Plourde-Research-Lab/JPM-SFQ/Figures/Figures.pptx

## ASC Paper Figures

## Basic Idea

Qubit/Cavity

1

0

M

JTL

JPM

## Circuit Diagram

Reset

DC-SFQ

Merger

5-cell ballistic JTL

5-cell ballistic JTL

JTL

JPM

M

I_(bias)

Trigger

DC-SFQ

Splitter

DFF

SFQ-DC

Out

Merger

5-cell ballistic JTL

-M

5-cell ballistic JTL

JTL

JTL
