Plourde-Research-Lab/JPM-SFQ/Figures/delay.pdf

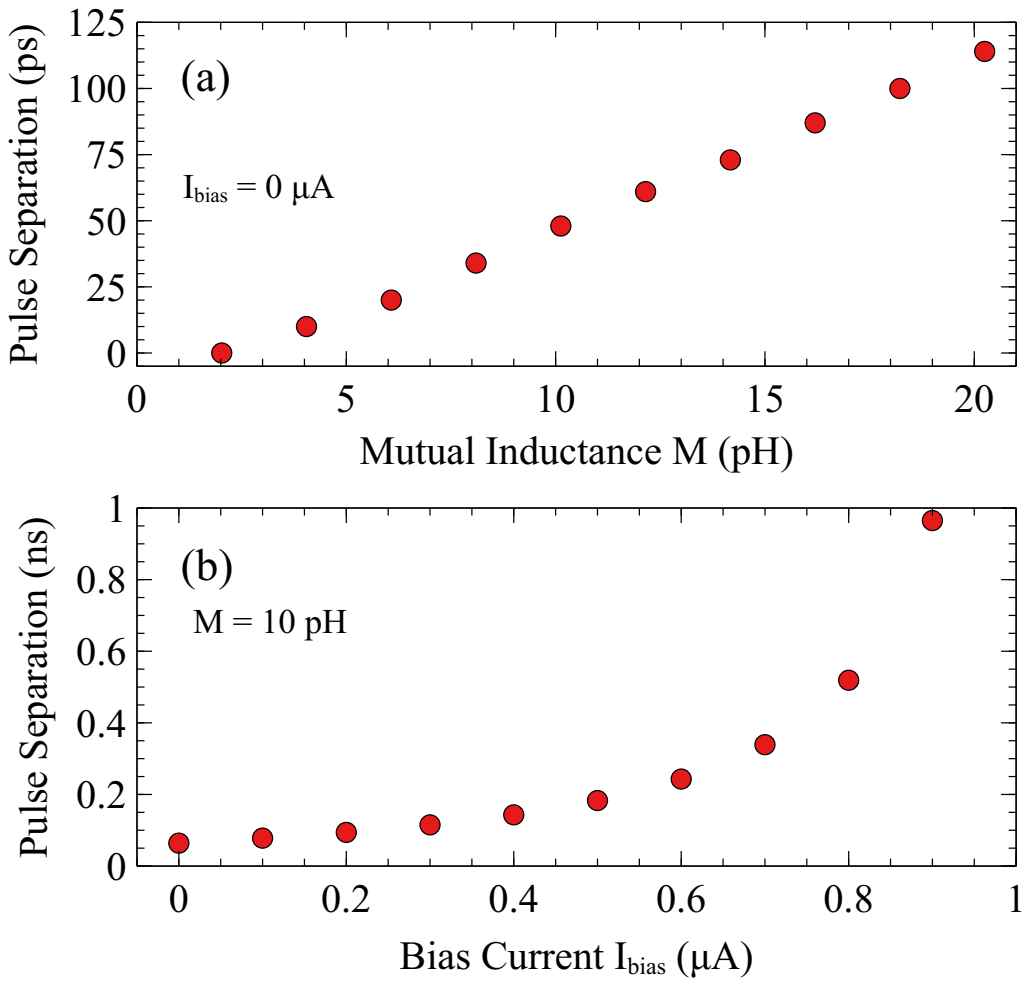
[picture p1: figure]
(a) Ibias =; Pulse Separation (ps); utual In; ductance M (p; Pulse Separation (ns); Bias C; urrent Ibias (μ
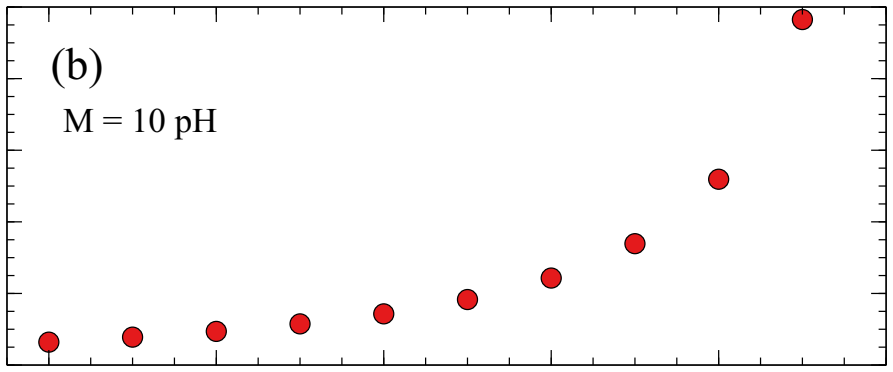
[picture p2: figure]
