Plourde-Research-Lab/JPM-SFQ/layout/extractions/ex1/ex1_circuit-schematic.pdf

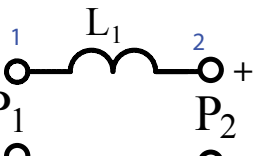
[picture p8: figure]

P

+
