Plourde-Research-Lab/JPM-SFQ/Comparator Readout/Comparator/Picture1.pdf

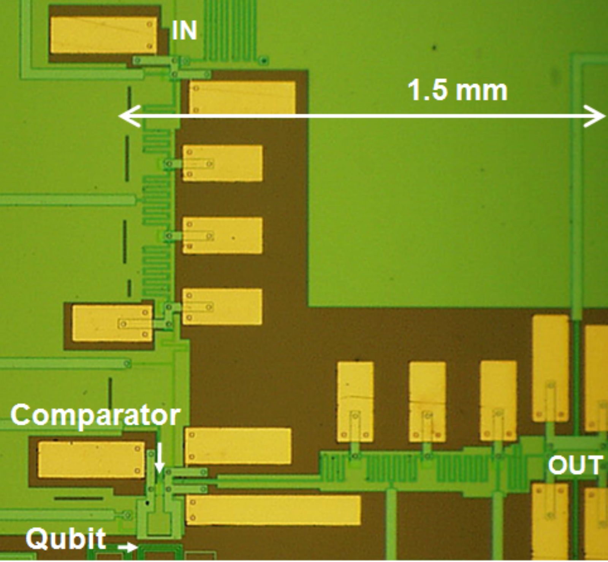
[picture p9: page 1]
