Plourde-Research-Lab/JPM-SFQ/Ballistic Readout/ASC Paper/Reviewer Responses-BP.pdf

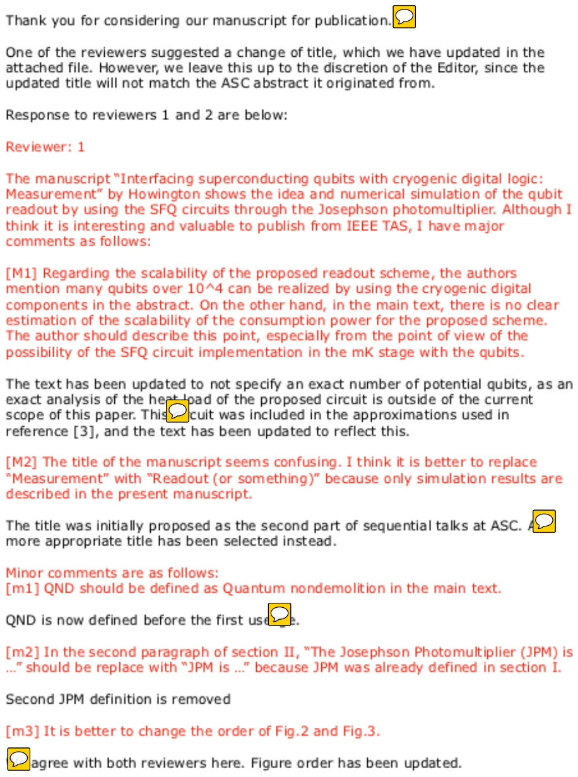
[picture p10: page 1]
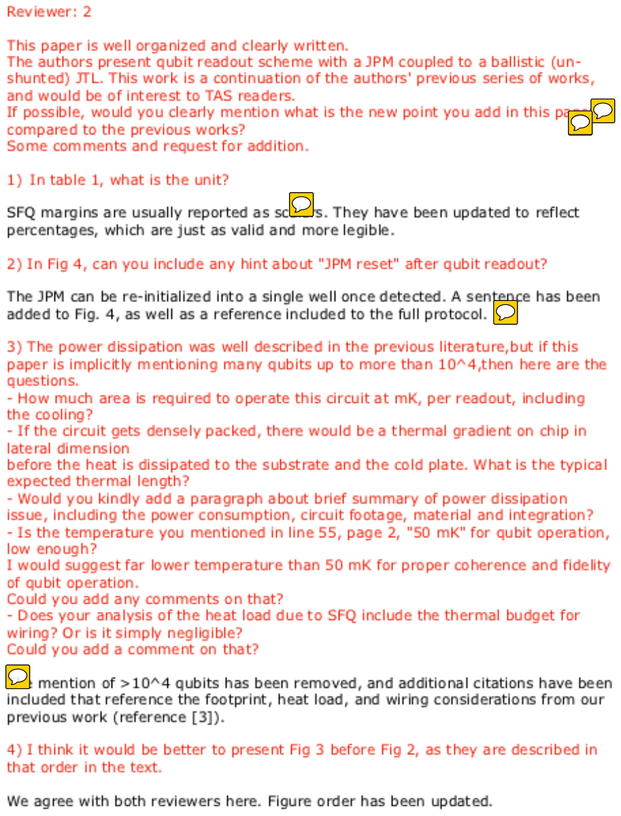
[picture p11: page 2]
