Plourde-Research-Lab/JPM-SFQ/components/rsfq_lib/suny_schematics/ANDschem.jpg

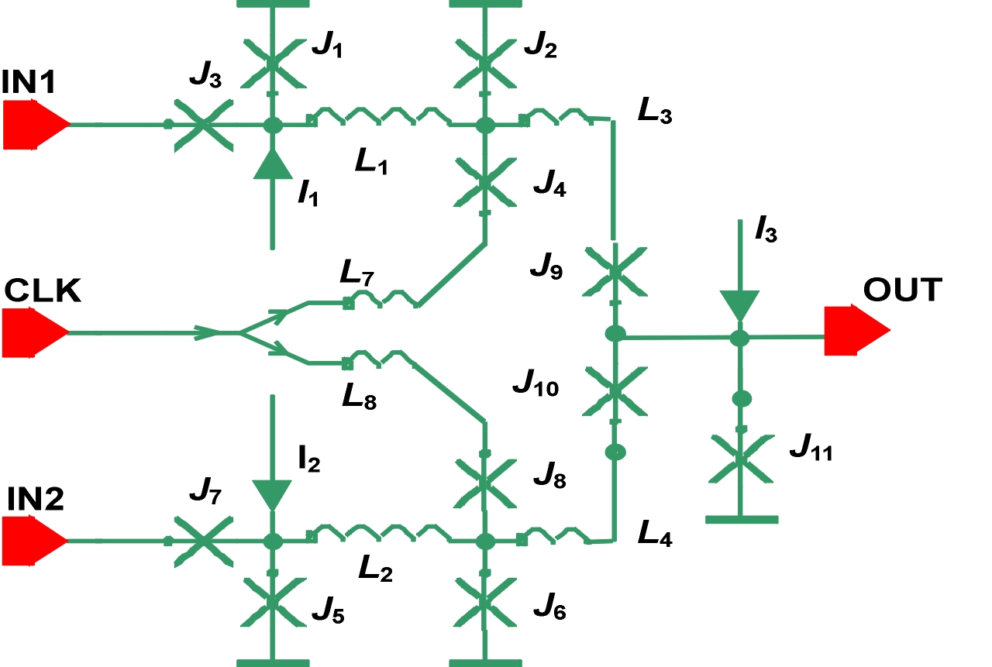
components/rsfq_lib/suny_schematics/ANDschem.jpg
