Plourde-Research-Lab/JPM-SFQ/components/rsfq_lib/suny_schematics/BFFschem.jpg

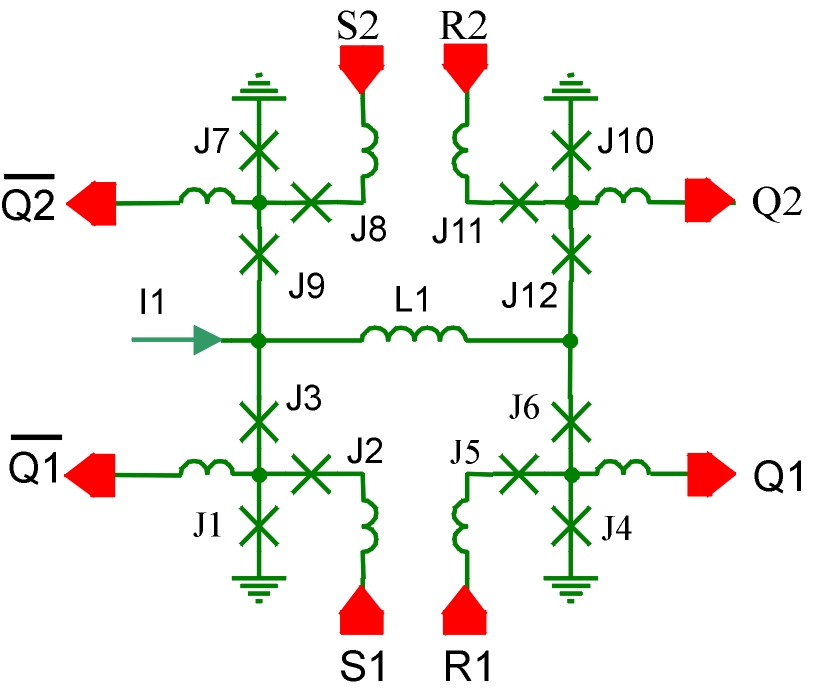
components/rsfq_lib/suny_schematics/BFFschem.jpg
