Plourde-Research-Lab/JPM-SFQ/components/rsfq_lib/suny_schematics/c-not.gif

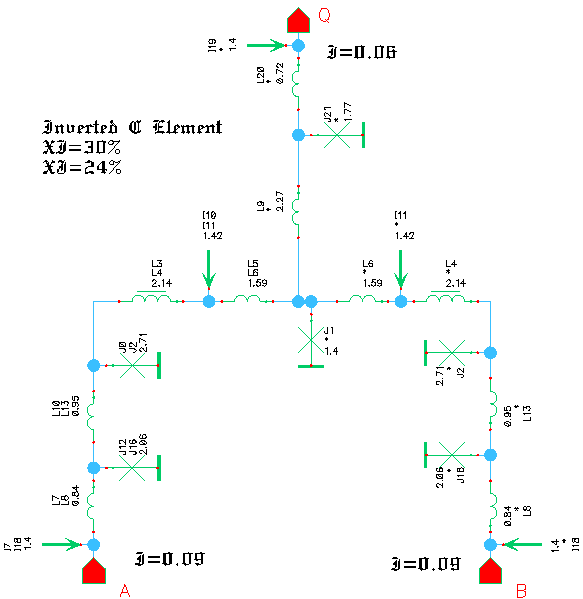
components/rsfq_lib/suny_schematics/c-not.gif
