Plourde-Research-Lab/JPM-SFQ/components/rsfq_lib/suny_schematics/d2.gif

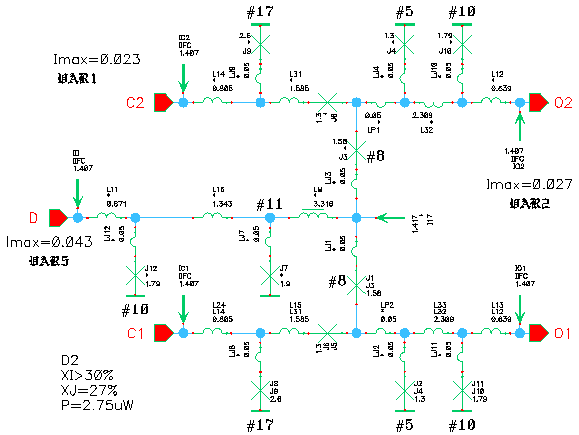
components/rsfq_lib/suny_schematics/d2.gif
