Plourde-Research-Lab/JPM-SFQ/components/rsfq_lib/suny_schematics/dcsfq-schematic.gif

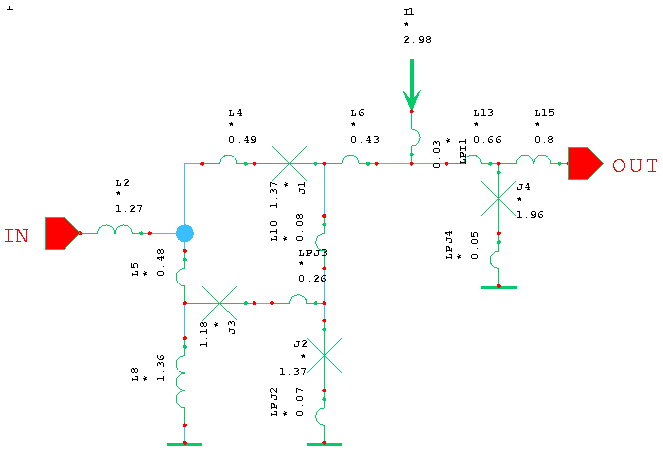
components/rsfq_lib/suny_schematics/dcsfq-schematic.gif
