Plourde-Research-Lab/JPM-SFQ/components/rsfq_lib/suny_schematics/dff-schematic.gif

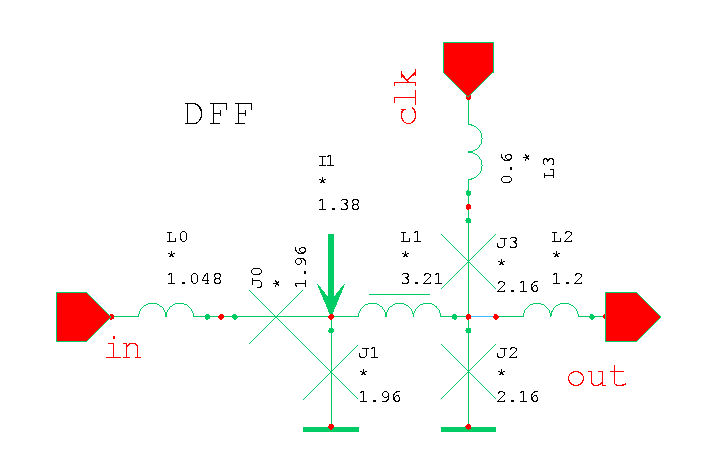
components/rsfq_lib/suny_schematics/dff-schematic.gif
