Plourde-Research-Lab/JPM-SFQ/components/rsfq_lib/suny_schematics/dffc.gif

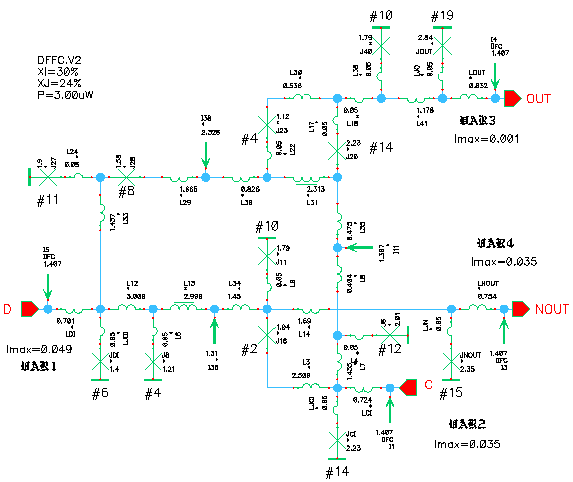
components/rsfq_lib/suny_schematics/dffc.gif
