Plourde-Research-Lab/JPM-SFQ/components/rsfq_lib/suny_schematics/inv.sch.gif

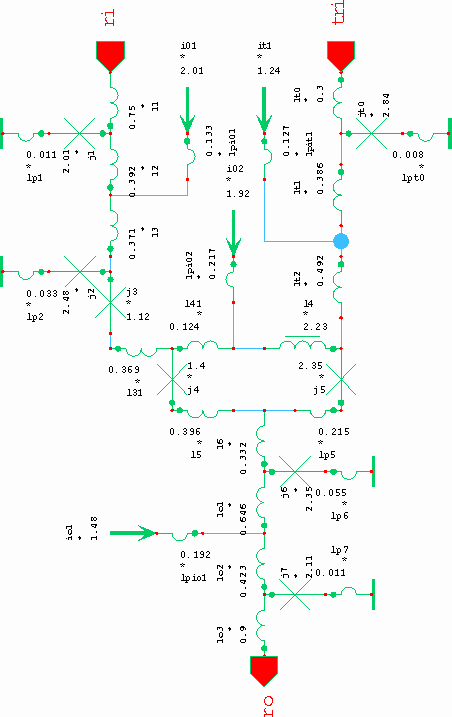
components/rsfq_lib/suny_schematics/inv.sch.gif
