Plourde-Research-Lab/JPM-SFQ/components/rsfq_lib/suny_schematics/jtl.sch.gif

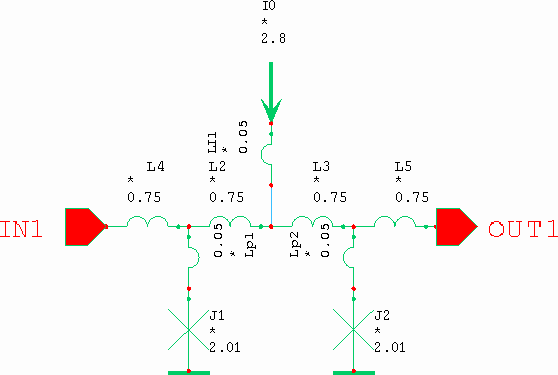
components/rsfq_lib/suny_schematics/jtl.sch.gif
