Plourde-Research-Lab/JPM-SFQ/components/rsfq_lib/suny_schematics/merge.sch.gif

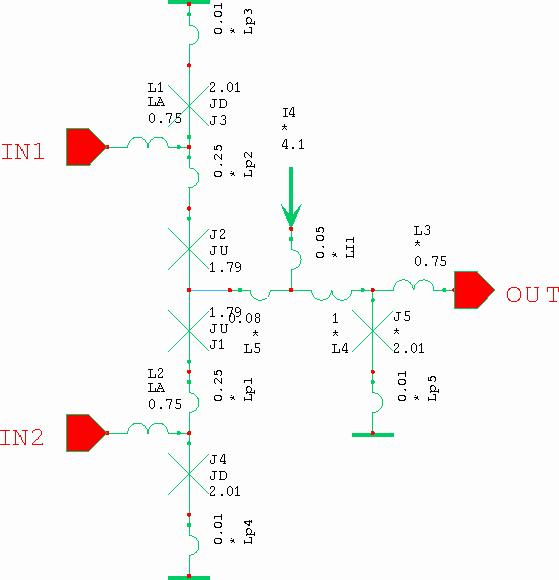
components/rsfq_lib/suny_schematics/merge.sch.gif
