Plourde-Research-Lab/JPM-SFQ/components/rsfq_lib/suny_schematics/msdrv.sch.gif

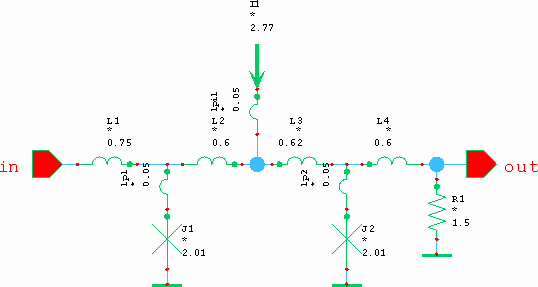
components/rsfq_lib/suny_schematics/msdrv.sch.gif
