Plourde-Research-Lab/JPM-SFQ/components/rsfq_lib/suny_schematics/msrec.sch.gif

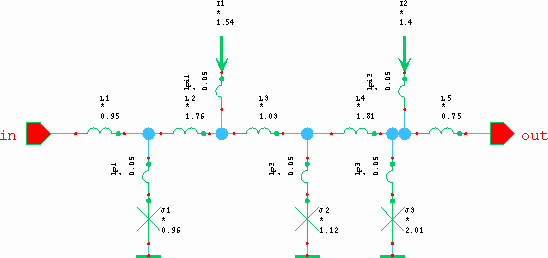
components/rsfq_lib/suny_schematics/msrec.sch.gif
