Plourde-Research-Lab/JPM-SFQ/components/rsfq_lib/suny_schematics/ndro-schematic.gif

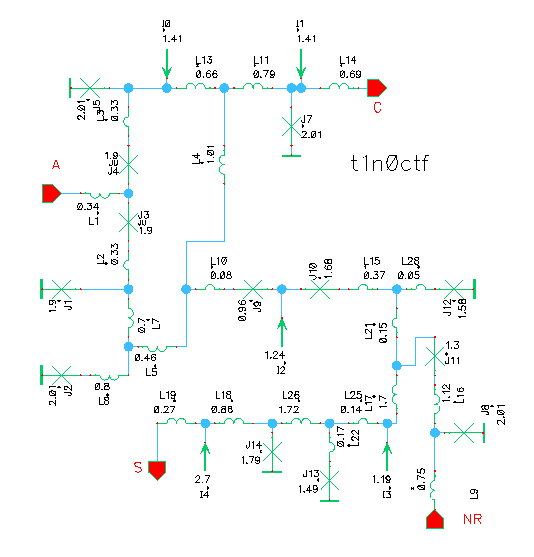
components/rsfq_lib/suny_schematics/ndro-schematic.gif
