Plourde-Research-Lab/JPM-SFQ/components/rsfq_lib/suny_schematics/ORschem.jpg

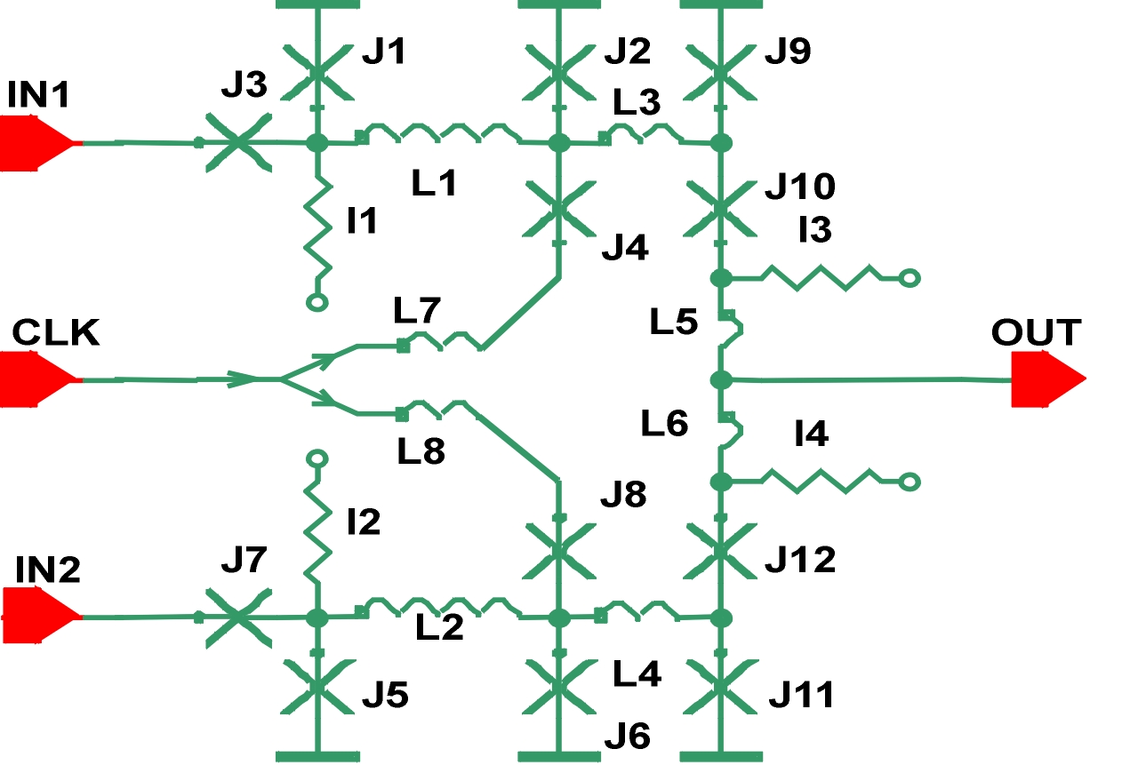
components/rsfq_lib/suny_schematics/ORschem.jpg
