Plourde-Research-Lab/JPM-SFQ/components/rsfq_lib/suny_schematics/sfqdc-schematic.gif

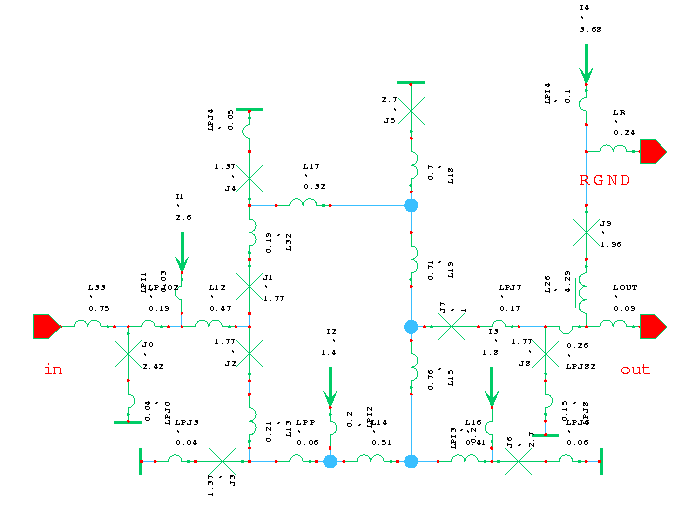
components/rsfq_lib/suny_schematics/sfqdc-schematic.gif
