Plourde-Research-Lab/JPM-SFQ/components/rsfq_lib/suny_schematics/split.sch.gif

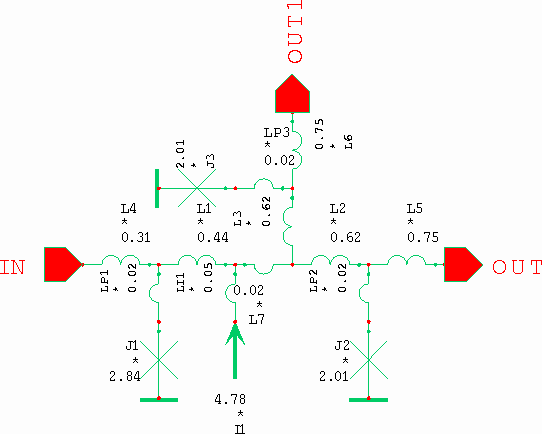
components/rsfq_lib/suny_schematics/split.sch.gif
