Plourde-Research-Lab/JPM-SFQ/components/rsfq_lib/suny_schematics/T1.schematics.gif

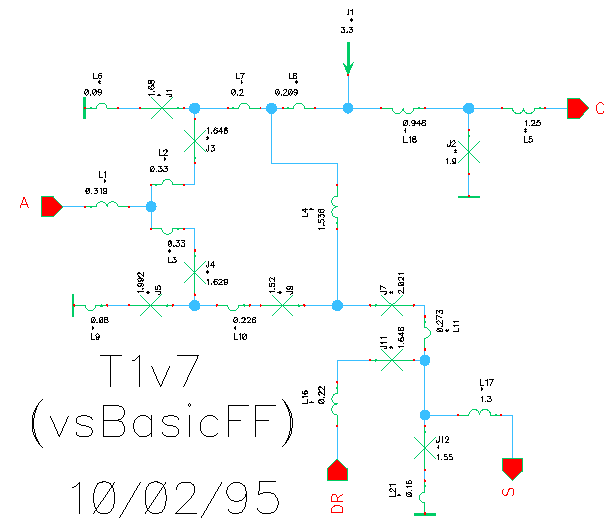
components/rsfq_lib/suny_schematics/T1.schematics.gif
