Plourde-Research-Lab/JPM-SFQ/components/rsfq_lib/suny_schematics/tbi2-sch.gif

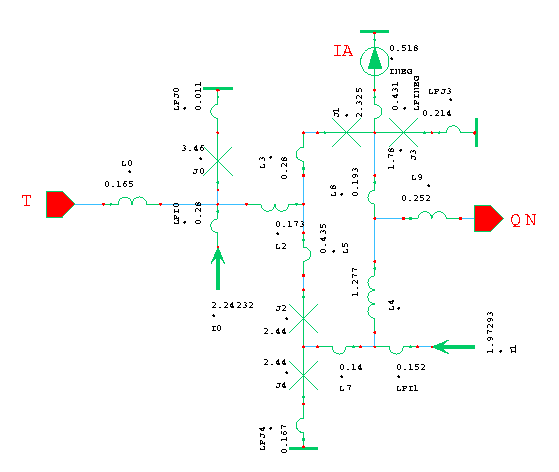
components/rsfq_lib/suny_schematics/tbi2-sch.gif
