Plourde-Research-Lab/JPM-SFQ/components/rsfq_lib/suny_schematics/xor-schematic.gif

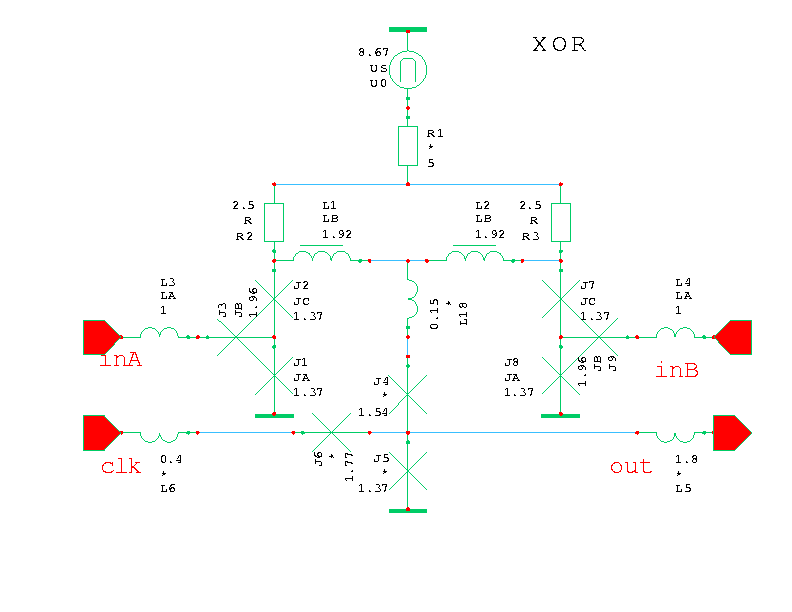
components/rsfq_lib/suny_schematics/xor-schematic.gif
