Plourde-Research-Lab/JPM-SFQ/layout/ComparatorLayout.png

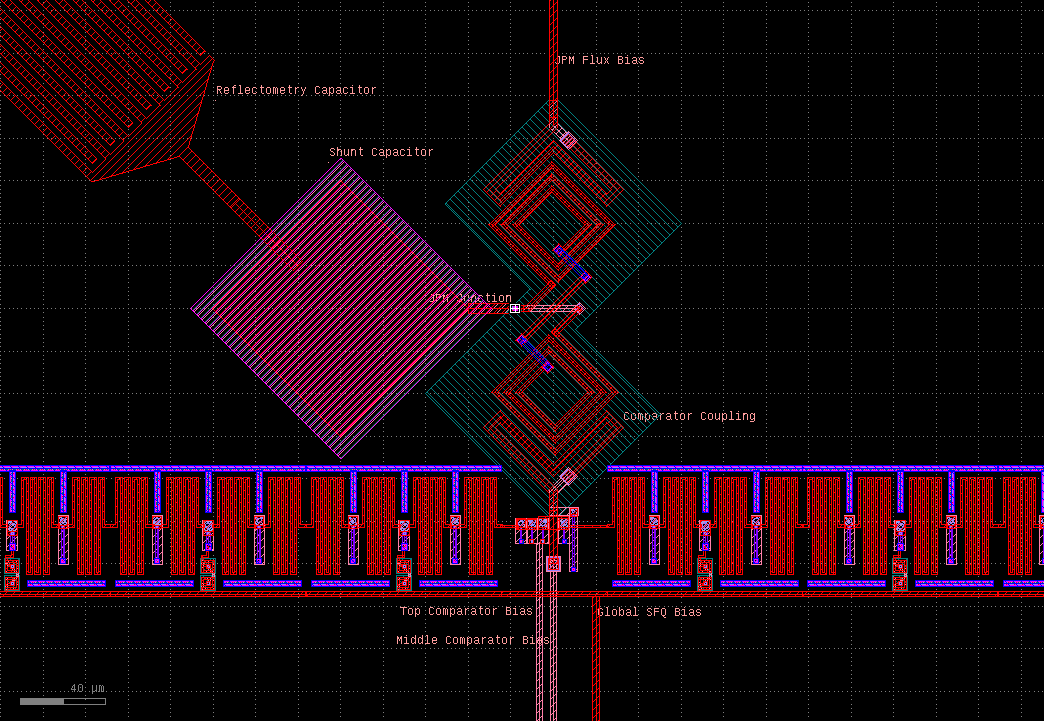
layout/ComparatorLayout.png
