Plourde-Research-Lab/JPM-SFQ/components/dc-sfq-dc/dc-sfq-dc.png

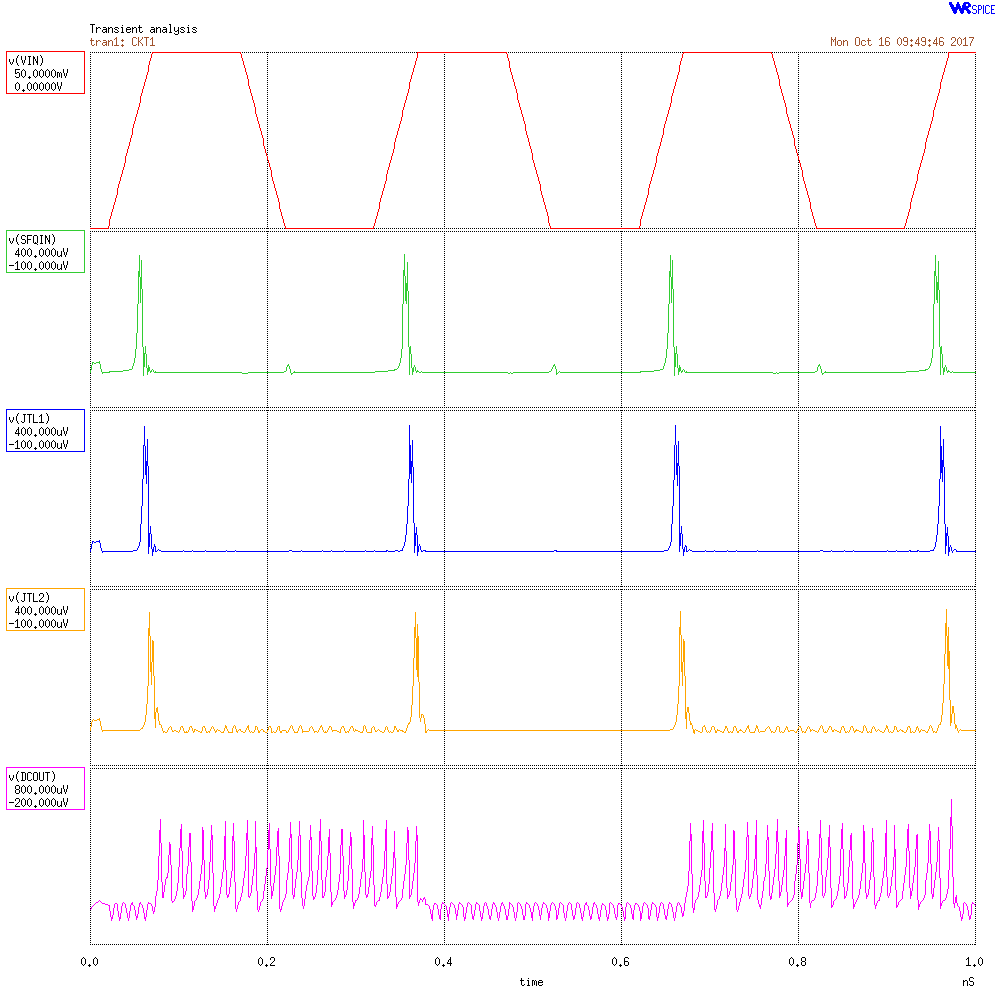
components/dc-sfq-dc/dc-sfq-dc.png
