Plourde-Research-Lab/JPM-SFQ/components/rsfq_lib/dff_schem.png

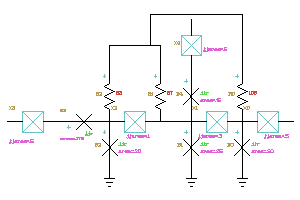
components/rsfq_lib/dff_schem.png
