Plourde-Research-Lab/JPM-SFQ/components/rsfq_lib/prbs_schem.png

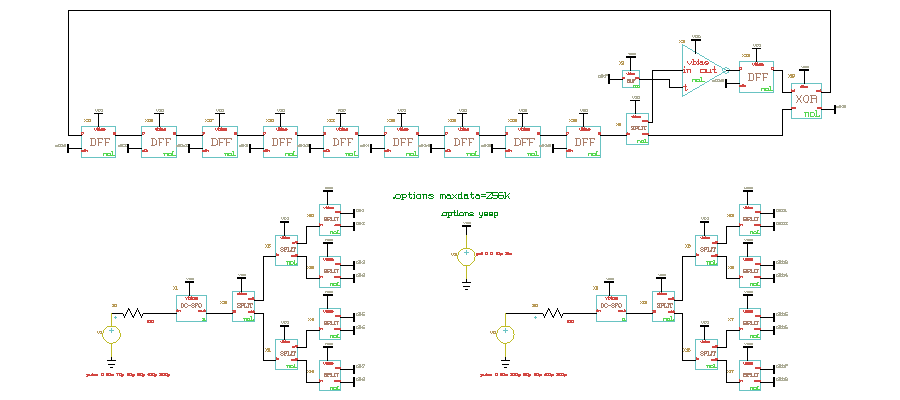
components/rsfq_lib/prbs_schem.png
