Plourde-Research-Lab/JPM-SFQ/components/rsfq_lib/prbs_sim.png

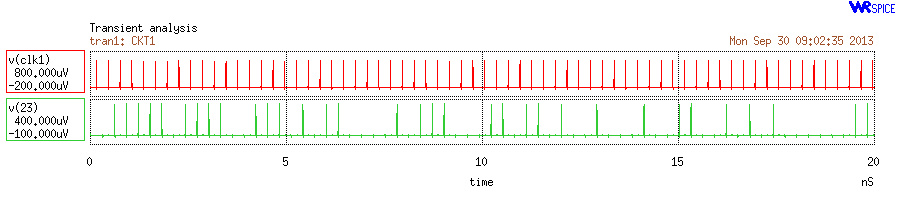
components/rsfq_lib/prbs_sim.png
