Plourde-Research-Lab/JPM-SFQ/components/SU-UWM-Driver/SU-UWM-Driver.png

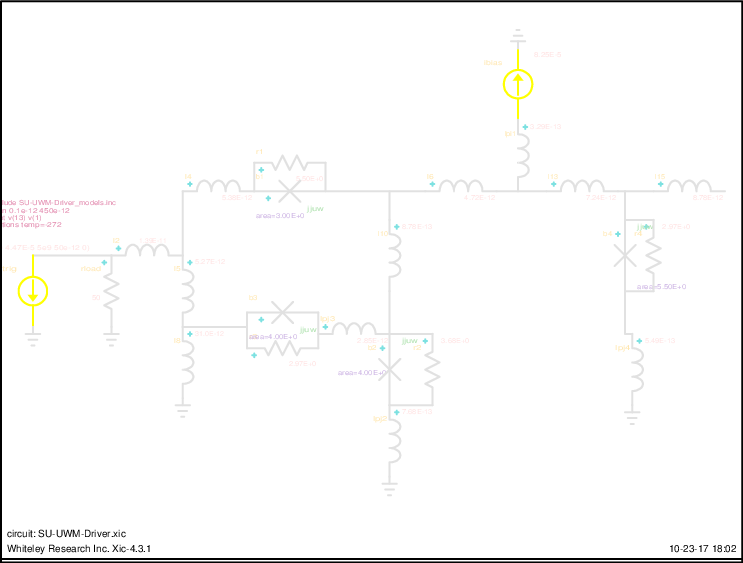
components/SU-UWM-Driver/SU-UWM-Driver.png
