Plourde-Research-Lab/JPM-SFQ/(list of files, cad)

Other CAD files:
layout/extractions/ex_m1/split.dxf
