Plourde-Research-Lab/JPM-SFQ/layout/extractions/test/test_a.txt

0.00000000,1.15463630,;
-1.15463630,0.00000000,;
