Plourde-Research-Lab/JPM-SFQ/components/dcsfq/result.png

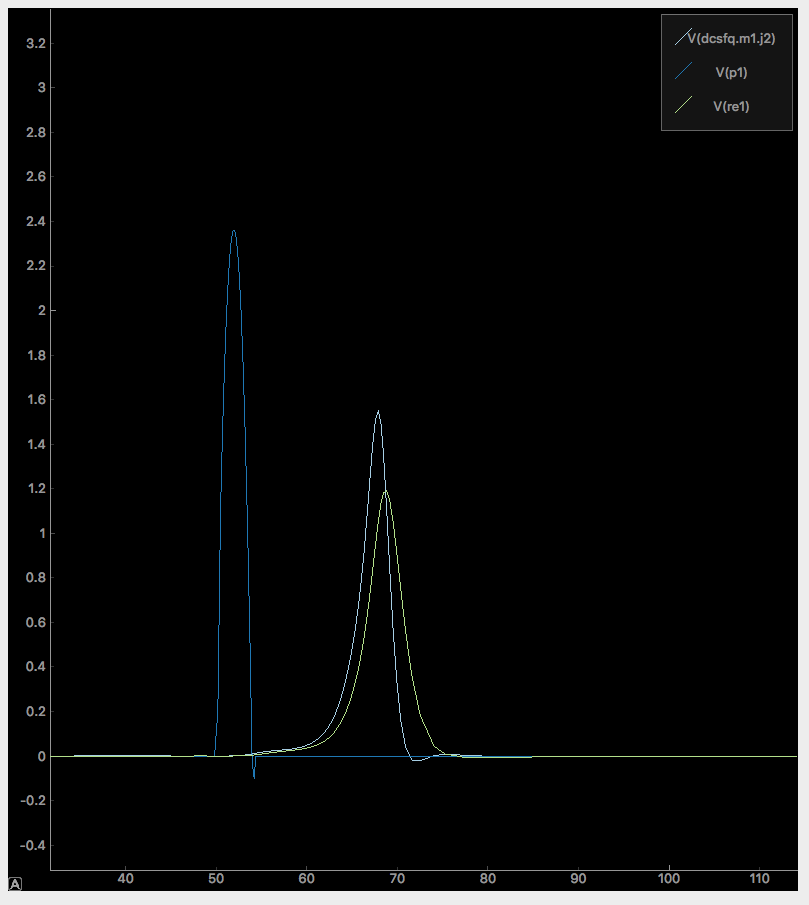
components/dcsfq/result.png
