Plourde-Research-Lab/JPM-SFQ/components/dff/pscan/result.png

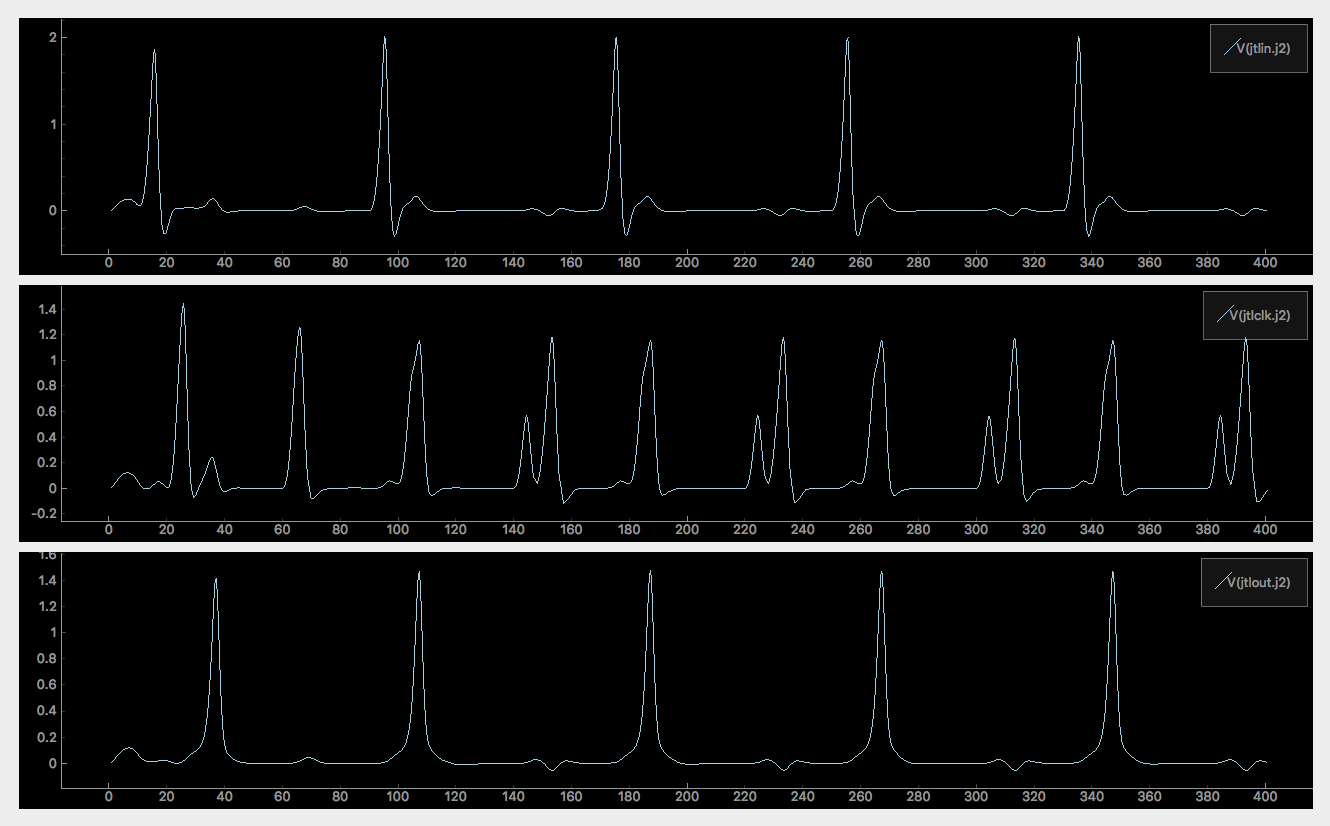
components/dff/pscan/result.png
