Plourde-Research-Lab/JPM-SFQ/components/splitter/result.png

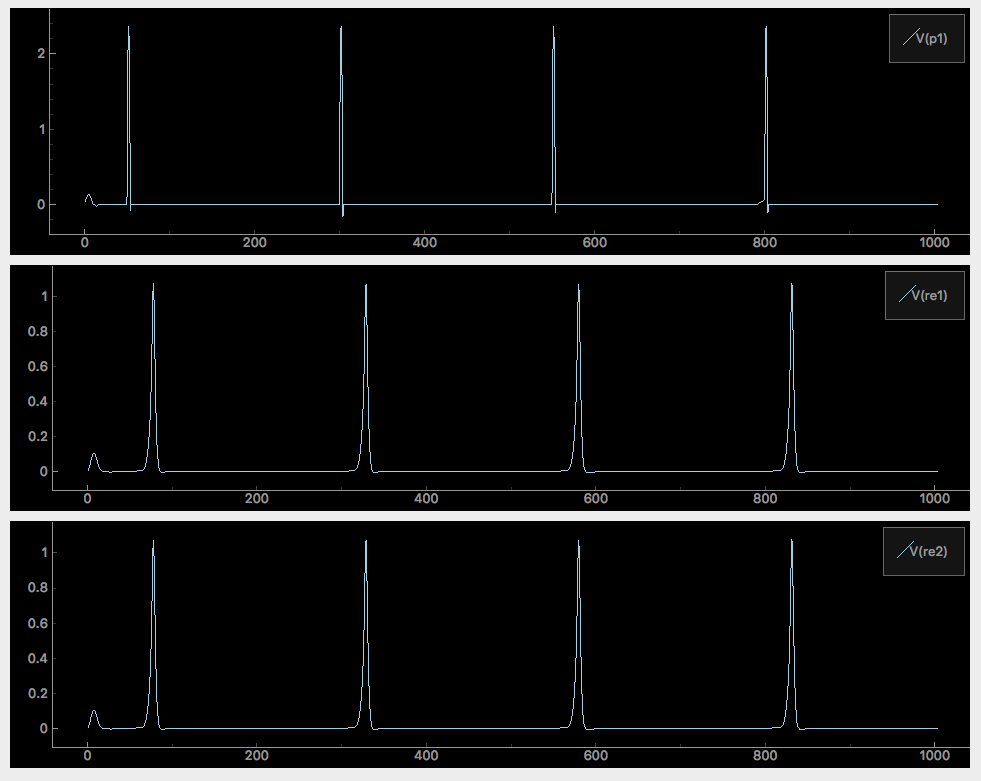
components/splitter/result.png
