Plourde-Research-Lab/JPM-SFQ/components/tff/result.png

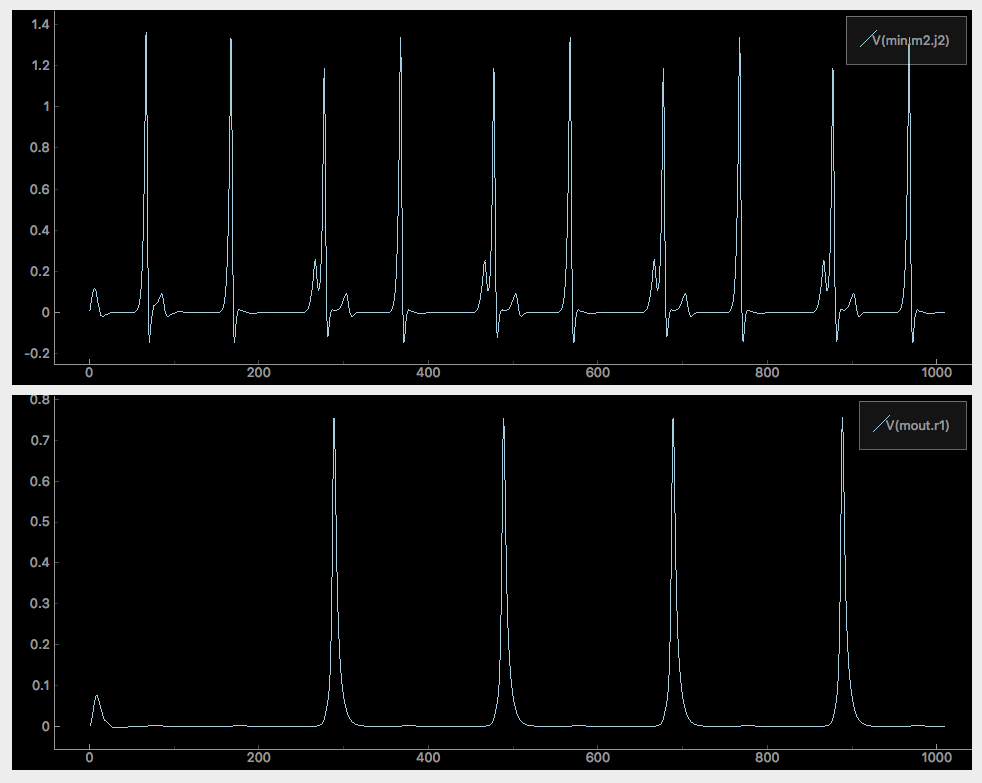
components/tff/result.png
