Plourde-Research-Lab/JPM-SFQ/Figures/Results.png

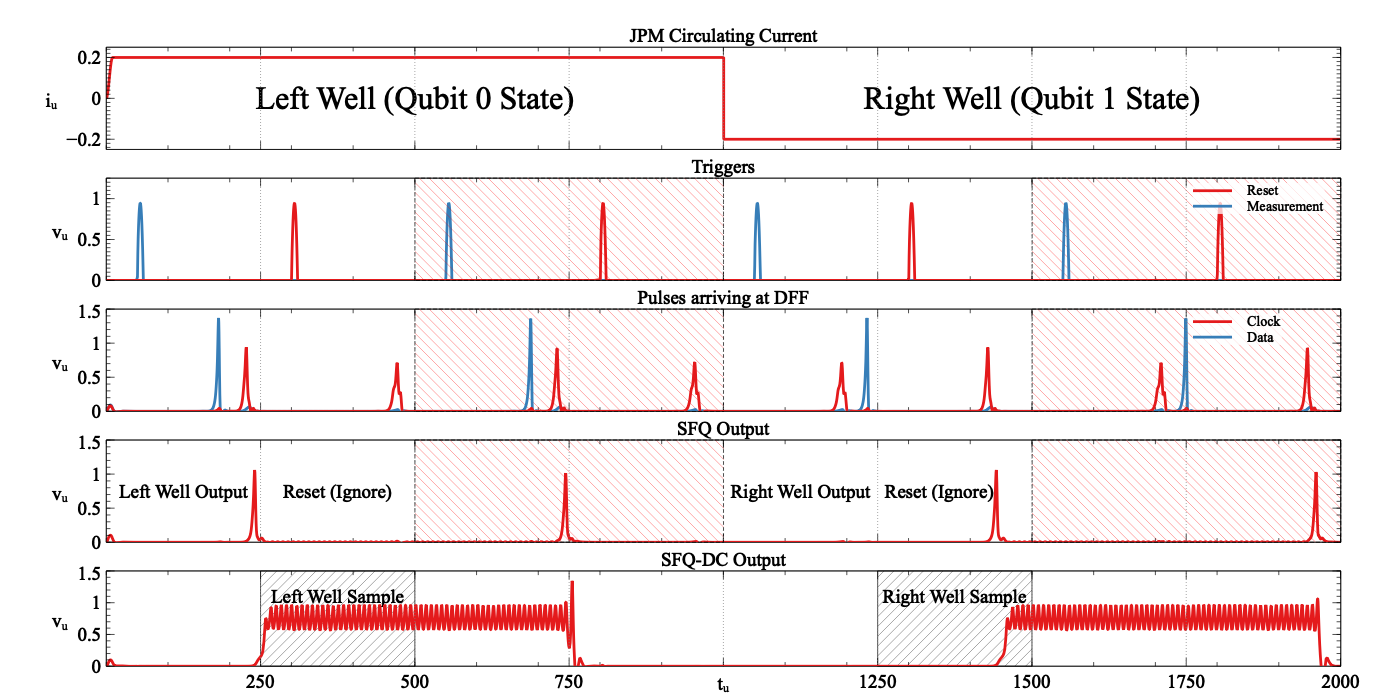
Figures/Results.png
