Plourde-Research-Lab/JPM-SFQ/Figures/Results.pdf

Left Well (Qubit 0 State) | Right Well (Qubit 1 State)

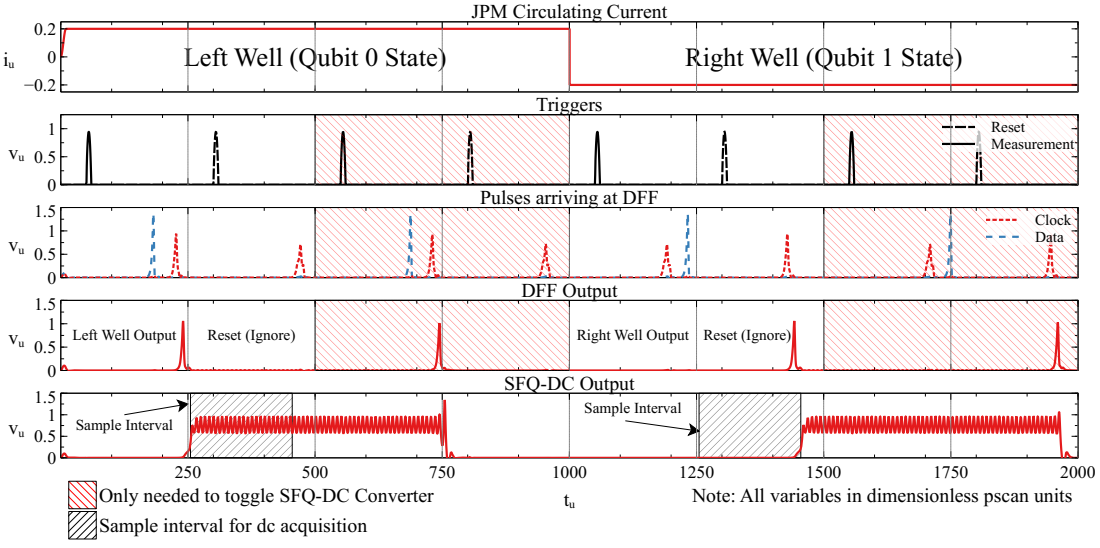
[picture p42: page 1]
Sample interval for dc acquisition; Only needed to toggle SFQ-DC Converter; Triggers; Reset Measurement; Clock Data; Left Well Output; Reset (Ignore); Right Well Output; DFF Output; Sample Interval

JPM Circulating Current

Pulses arriving at DFF

SFQ-DC Output

Note: All variables in dimensionless pscan units
