Plourde-Research-Lab/JPM-SFQ/components/SU-UWM-Driver/SU-UWM-Driver.pdf

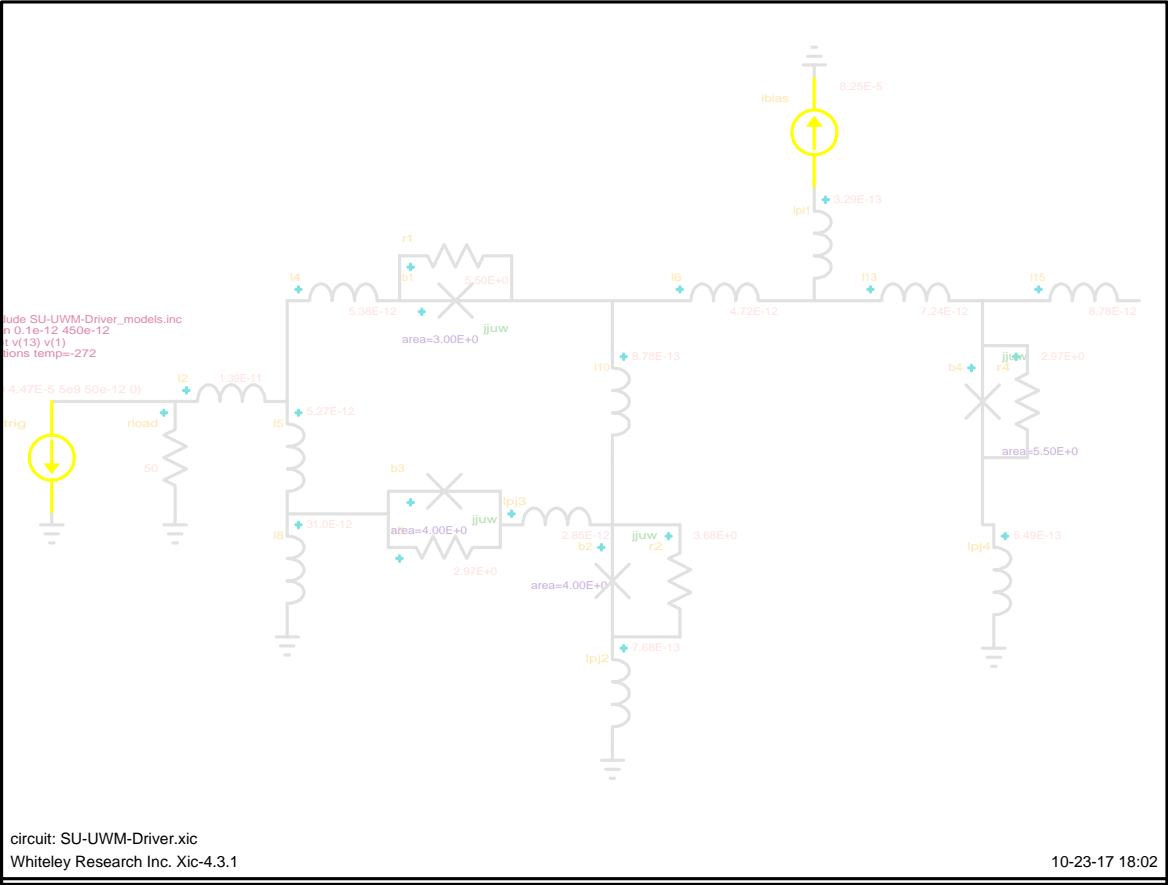
[picture p43: page 1]
ibias; lpi1; itrig; rload; lpj3; lpj4; lpj2; jjuw; area=3.00E+0; area=5.50E+0; area=4.00E+0; Whiteley Research Inc. Xic-4.3.1

clude SU-UWM-Driver_models.inc
ptions temp=-272

circuit: SU-UWM-Driver.xic
