Plourde-Research-Lab/JPM-SFQ/layout/extractions/ex_m1/ex_m1_circuit-schematic.pdf

## 11 PIB + 4

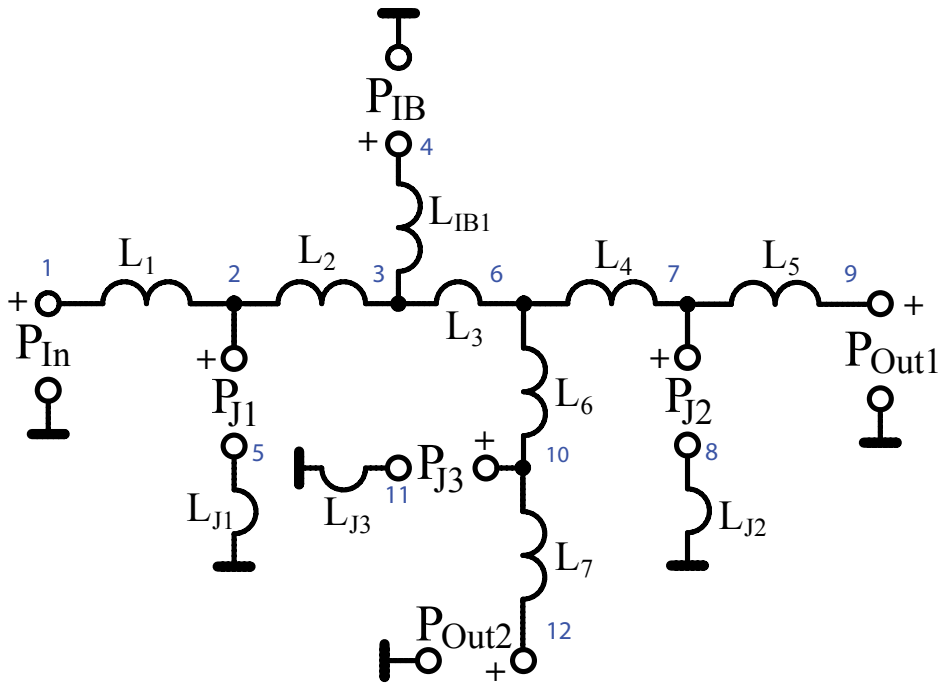
[picture p44: page 1]
PIn +; 9POut1+; POut2; LIB1 L3
