Plourde-Research-Lab/JPM-SFQ/Figures/Comparator Results.pdf

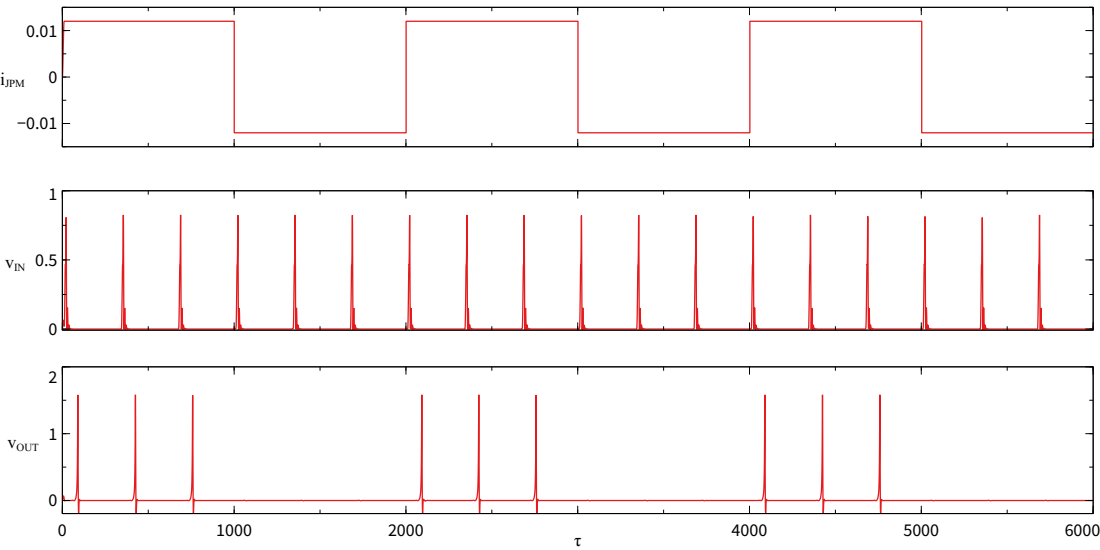
[picture p45: page 1]
iJP; M−0.010 0.01 vIN; 0 0.51 vOUT 012
