Plourde-Research-Lab/JPM-SFQ/components/MutualExample/drv01.pdf

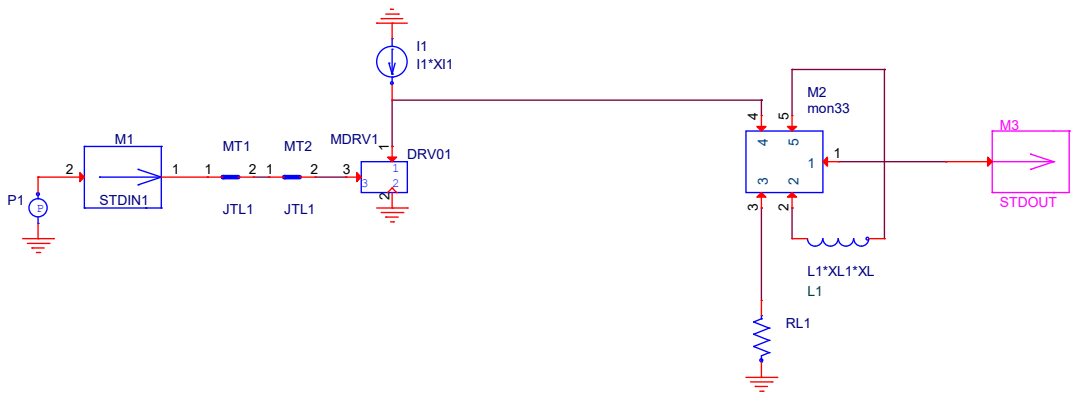
[picture p46: page 1]
Title; Size; Document Number; Rev; Date:; Sheet; <Doc>; <RevCode>; Monday, March 20, 2017; STDOUT; JTL1; M2 mon33; STDIN1; 3 2 MDRV1; DRV01

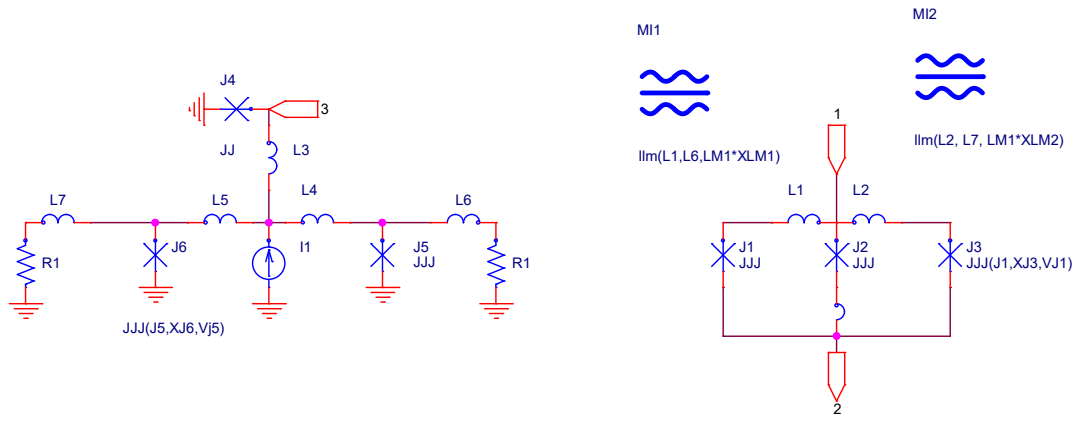
[picture p47: page 2]

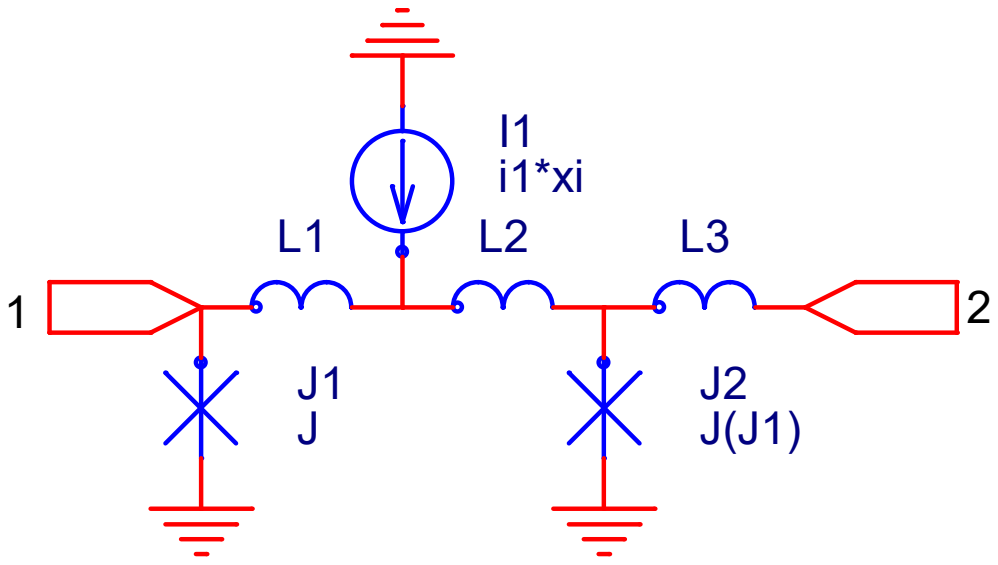
[picture p48: page 3]
Title; Size; Document Number; Rev; <Doc>; <RevCode>; JTL1; Saturday, February 18, 2017

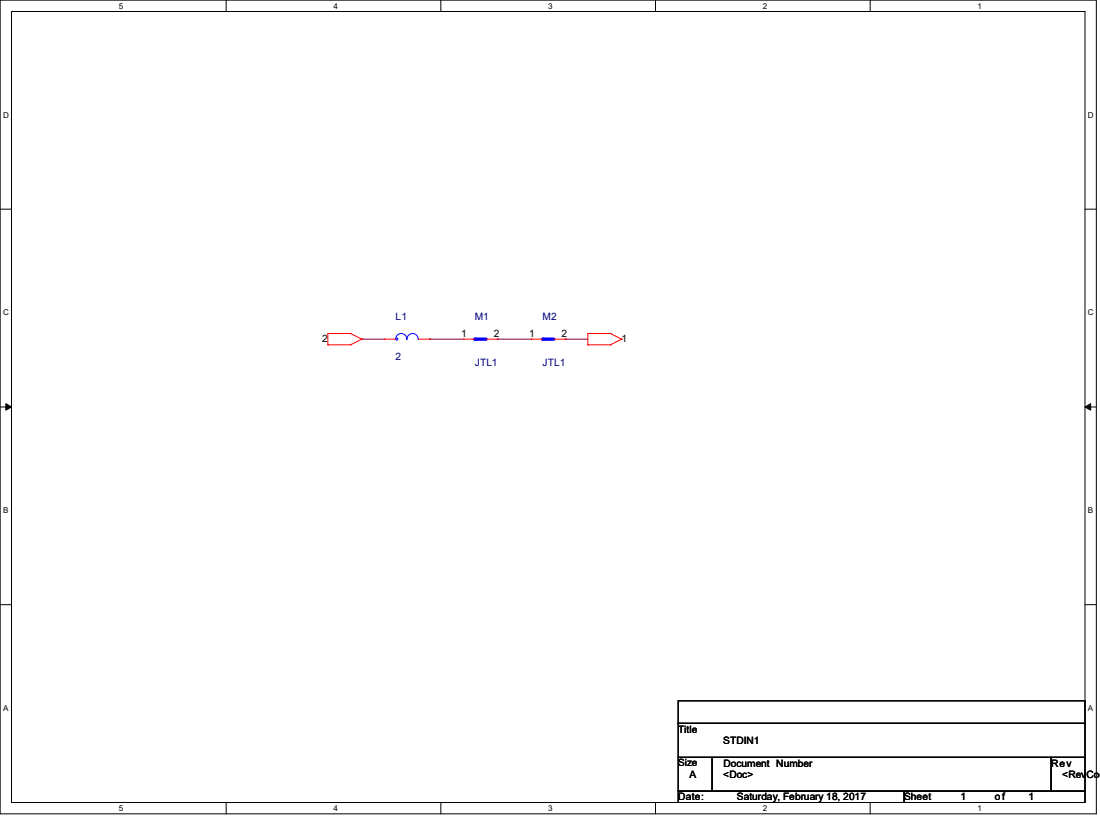
[picture p49: page 4]
Title; Size; Document Number; Rev; <Doc>; <RevCode>; STDIN1; JTL1

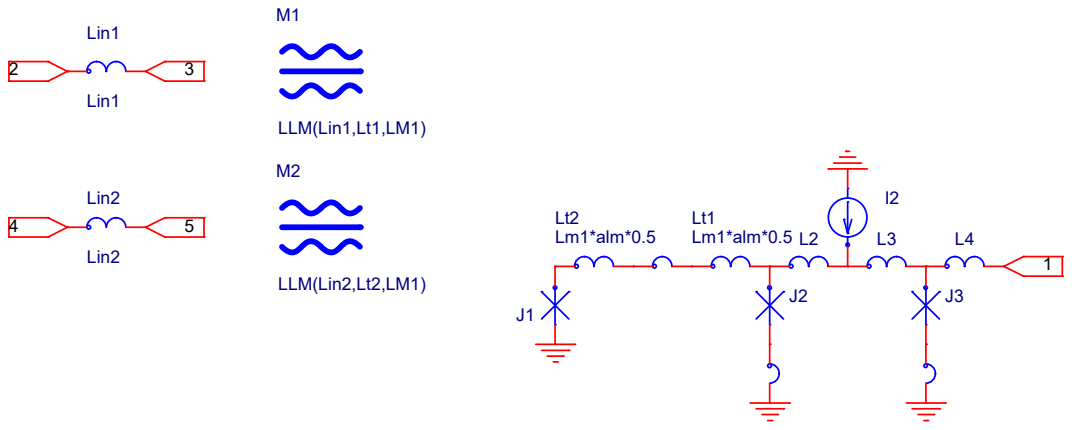
[picture p50: page 5]
Title; Size; Document Number; Rev; <Doc>; <RevCode>; mon33; Sunday, March 19, 2017; Lin2; LLM(Lin2,Lt2,LM1); Lt2 Lm1*alm*0.5; LLM(Lin1,Lt1,LM1); Lin1; Lt1 Lm1*alm*0.5

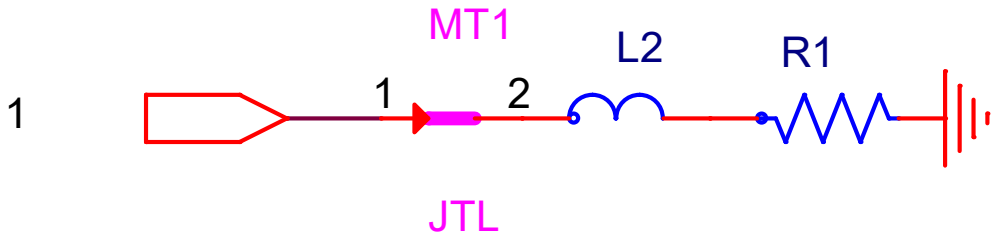
[picture p51: page 6]
Title; Size; Document Number; Rev; <Doc>; <RevCode>; STDOUT; JTL

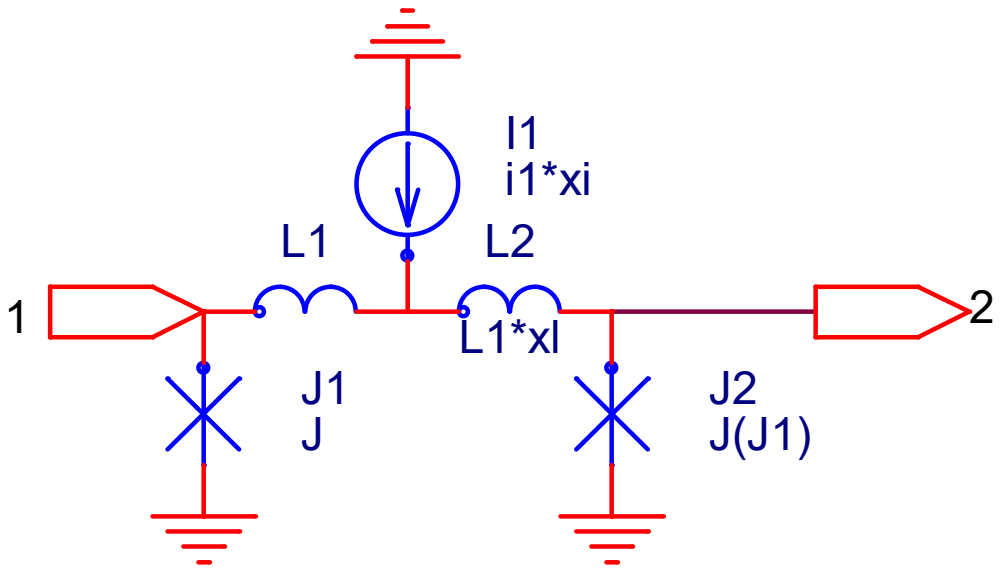
[picture p52: page 7]
Title; Size; Document Number; Rev; <Doc>; <RevCode>; JTL; Monday, April 17, 2017
