Plourde-Research-Lab/JPM-SFQ/Figures/Circuit.pdf

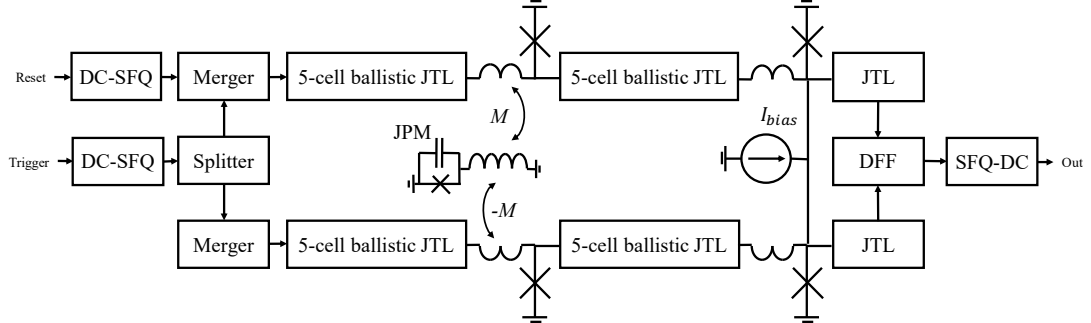
[picture p53: page 1]
DC-SFQ; Splitter; Merger; JPM; DFF; JTL; Trigger; Reset; Out; SFQ-DC

5-cell ballistic JTL
