Plourde-Research-Lab/JPM-SFQ/Figures/Fluxon.pdf

1

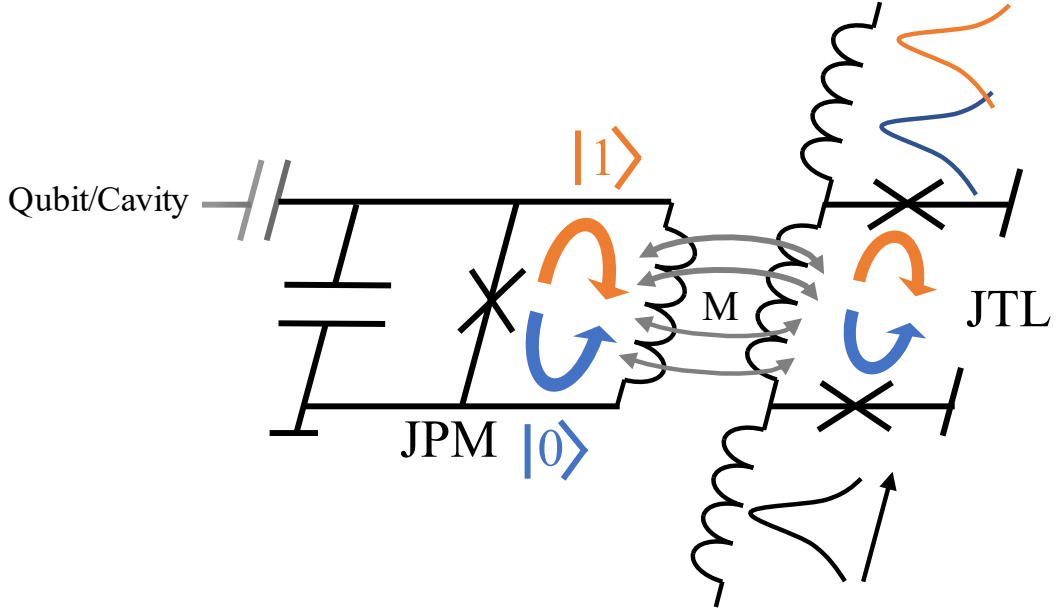
[picture p54: page 1]
JPM; JTL; Qubit/Cavity
