Plourde-Research-Lab/JPM-SFQ/Ballistic Readout/RaceArbiterV2/pscan2/Results.pdf

# JPM-SFQ Interface

Left Well | Right Well

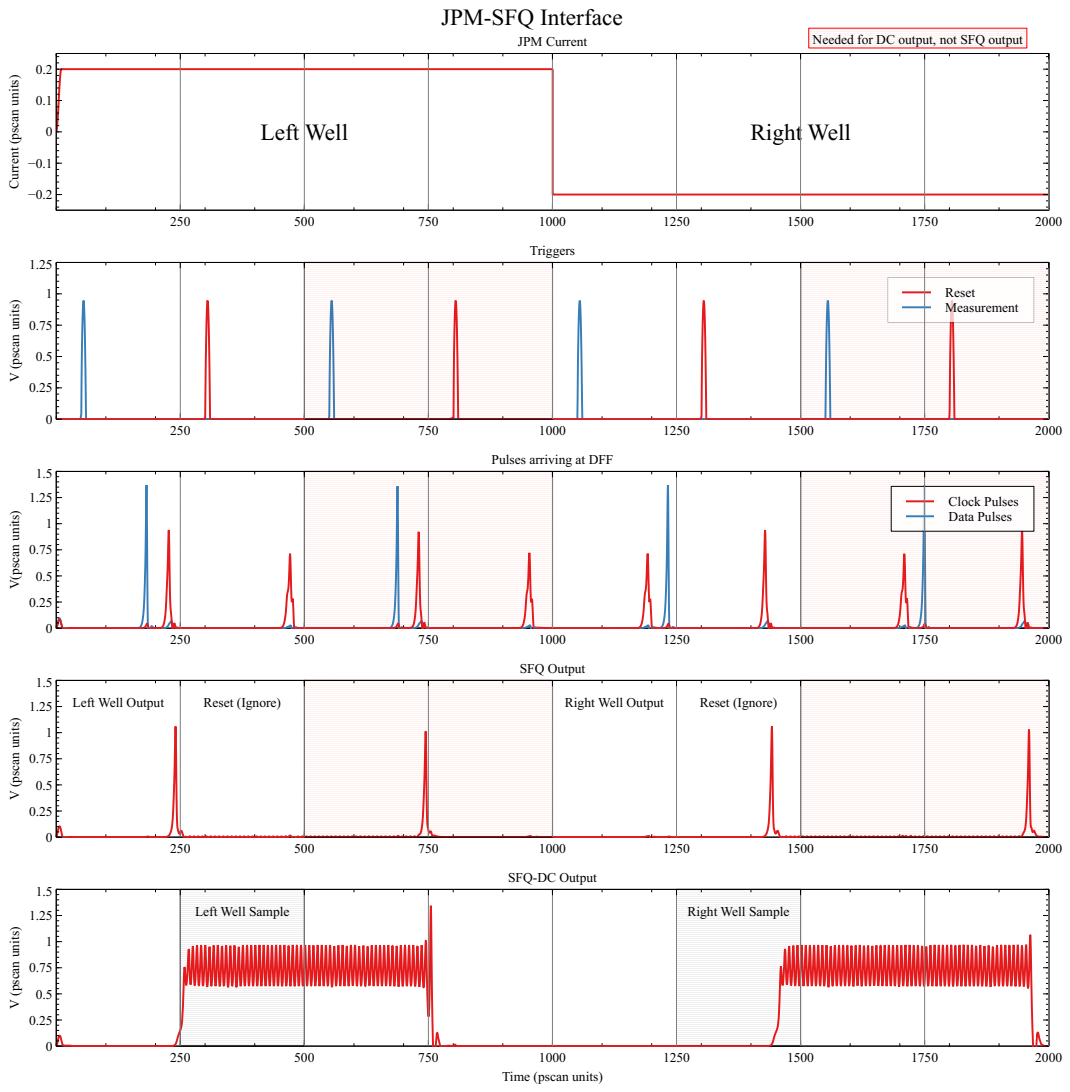
[picture p56: page 1]
JPM Current; nt (psc; nits) −0.2; Triggers; Reset Measurement; V (psc; nits); Clock Pulses Data Pulses; V(psc; Left Well Output; Reset (Ignore); Right Well Output; SFQ Output; Left Well Sample; Right Well Sample

Needed for DC output, not SFQ output

Pulses arriving at DFF

SFQ-DC Output

Time (pscan units)
