Plourde-Research-Lab/JPM-SFQ/components/JTL/JTLSCHEMATIC1.CIR

* source JTL
.SUBCKT SCHEMATIC1  
.ENDS SCHEMATIC1
