Plourde-Research-Lab/JPM-SFQ/(list of files, drawings)

Other design files:
Ballistic Readout/RaceArbiterV1/JPM RACE ARBITER.DSN
Ballistic Readout/RaceArbiterV1/JPM Race Arbiter.opj
Ballistic Readout/RaceArbiterV3/JPM RACE ARBITER.DSN
Ballistic Readout/RaceArbiterV3/JPM Race Arbiter.opj
Comparator Readout/Comparator/orcad/COMPARATOR.DSN
Comparator Readout/Comparator/orcad/Comparator.opj
Comparator Readout/ComparatorV2/orcad/COMPARATORV2.DSN
Comparator Readout/ComparatorV2/orcad/ComparatorV2.opj
components/JTL/DESIGN1.DSN
components/JTL/Design1.opj
components/JTL/DESIGN2.DSN
components/JTL/Design2.opj
components/JTL/DESIGN3.DSN
components/JTL/Design3.opj
components/JTL/DESIGN4.DSN
components/JTL/Design4.opj
components/JTL/DESIGN5.DSN
components/JTL/Design5.opj
components/JTL/DESIGN6.DSN
components/JTL/Design6.opj
components/JTL/DESIGN7.DSN
components/JTL/Design7.opj
components/JTL/DESIGN8.DSN
components/JTL/Design8.opj
components/JTL/JTL.DSN
components/JTL/JTL.opj
components/MutualExample/design1.DSN
components/MutualExample/design1.opj
JPM Models/JPM MODEL.DSN
JPM Models/JPM Model.opj
JPM Models/JPM.DSN
