Plourde-Research-Lab/JPM-SFQ/(commit log)

2017-11-02 Underdamped JTL with coupled segment
2017-11-02 flux bias sweep and annotated circuit deck
2018-04-26 Full JPM-SFQ detection circuit
    [JPM RACE ARBITER.DSN, JPM Race Arbiter.opj, root_param.txt]
2018-04-26 DFF Circuit
2018-04-26 TFF circuit
    [root_param.txt]
2018-04-26 Splitter circuit
2018-04-26 JTL Coupled to flux loop circuit
    [currents.csv, root_param.txt]
2018-04-27 Updated for correct rules and margin analysis
    [root_param.txt]
2018-04-27 Separate simulation and analysis of delat detection circuit
    [root_param.txt]
2018-09-14 Newest working state
    [PSCAN Conversion.xlsx, design1.DSN, design1.opj, longjj_param.txt, root_param.txt]
2018-09-14 Restructuring, removing old stuff
    [JPM RACE ARBITER.DSN, JPM Race Arbiter.opj, currents.csv, design1.DSN, design1.opj, longjj_param.txt, root_param.txt]
2018-09-14 Added new files from network drive
    [DESIGN1.DSN, DESIGN2.DSN, DESIGN3.DSN, DESIGN4.DSN, DESIGN5.DSN, DESIGN6.DSN, DESIGN7.DSN, DESIGN8.DSN]
2018-10-10 Race Arb versions
    [PSCAN Conversion.xlsx]
2018-10-16 reorganized extractions, started using full inductex version.
    [split.dxf]
2018-10-24 data for figures
    [bias.csv, mutual.csv]
2018-10-24 New Xic/wrspice model with simulation results
    [sweepdata.csv]
2018-10-25 coupling extraction sim
2018-11-05 create figure folder
    [data.csv]
2018-11-12 Comparator Orcad layout
    [COMPARATOR.DSN]
2018-11-19 Comparator circuit from Tom
2018-11-27 Adding Comparator V1 and V2
    [proot_param.txt, root_param.txt]
2019-02-18 Newest comparator version, based from Tom O
    [COMPARATOR.DSN, Comparator.opj]
2019-02-18 Updated Comparator design to work with JPM, pscan2 sims included
    [COMPARATORV2.DSN, ComparatorV2.opj]
2019-02-18 Capacitance extractions
    [C Matrix Table 1.csv]
2019-02-18 Qucs simulation
    [Cav.sch, Full Circuit.sch, Impedance.sch, JPM Cell.sch, JPM.csv, JPM.dat.cfg, JPM.sch, JTL Cell.sch]
2019-04-10 Inductex Sim of latest JPM with latest comparator coupling
2019-04-10 JPM-CMP coupling GDS
2019-04-10 orcad project
    [ComparatorV2.opj]
2019-04-10 pscan cmp results
    [50uA_proot_param.txt]
2019-04-10 Yet another comparator version
    [proot_param.txt]
2019-04-10 Circuit deck and data file for scripted sweeps
2019-04-10 Circuit Deck and data for switching probability sweeps
2019-04-10 Restructured files
    [50uA_proot_param.txt, COMPARATOR.DSN, COMPARATORV2.DSN, Comparator.opj, ComparatorV2.opj, JPM RACE ARBITER.DSN, JPM Race Arbiter.opj, ROOT.DSN]
2019-04-10 design rules and rmoved old spreadsheet
    [PSCAN Conversion.xlsx]
